houseofnorth/mpmother/media/Controller.png

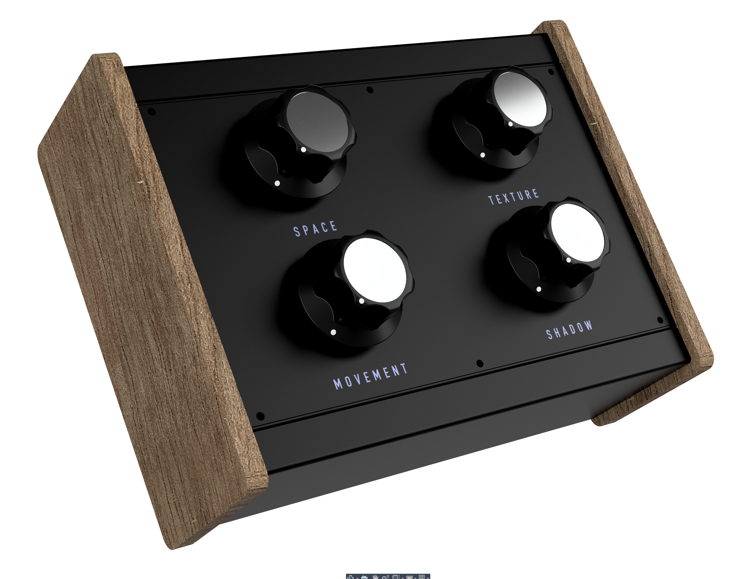
media/Controller.png
