houseofnorth/mpmother/(commit log)

2026-11-06 Import Teensy 3.2 Motorpot sketch
2026-11-06 Convert to PlatformIO project for Teensy 4.1
    Sketch moved unchanged to src/main.cpp; still uses the old 3.2 pin map.
2026-11-06 MPMOTHER v1 firmware and web config tool
    - Teensy 4.1 pin map, 2x DRV8833 at 20 kHz with sleep and fault handling
    - Dual-wiper pots with wear and broken-gang detection
    - Knob states: idle, follow, user, saver, fault
    - Separate drive channel for Ableton plus mapping feedback
    - Watchdog, move timeouts, safe boot, RGB status LED
    - SysEx protocol and WebMIDI config/monitor page in docs/
    [console.cpp, knobs.cpp, knobs.h, led.cpp, led.h, main.cpp, midi_io.cpp]
2026-11-06 Config tool: black DIN Condensed redesign, live plots, demo mode
    - Rolling 10 s plot per knob: position, motor target, hand-on band
    - Ports auto-detected by name; picker only appears if MPMOTHER is not found
    - Two-click confirm instead of browser pop-ups
    - Demo mode simulates a controller for trying the page without hardware
2026-11-06 Remove screensaver
    Firmware, config tool, protocol and docs. Settings block is now 32 bytes;
    EEPROM magic bumped so old settings reset to defaults.
    [console.cpp, knobs.cpp, knobs.h, led.cpp, led.h, main.cpp, midi_io.cpp, settings.cpp]
2026-11-06 Config tool: hardware-editor settings banks and maintenance section
    - Settings as parameter cells (drag, scroll, arrows, +/-), banks A MIDI, B Motor, C Mapping
    - Changed values marked until saved; save bar shows change count, revert
    - Maintenance table: calibrated range, motor direction, pot wear, fault per knob
    - Per-knob calibration (firmware + protocol: calibrate takes a knob index)
    [console.cpp, knobs.cpp, knobs.h, main.cpp, midi_io.cpp, midi_io.h]
2026-11-06 Config tool: drop Knobs heading, 70s modular panel touches
    Warm silkscreen white, pilot-lamp orange status lamps, panel screws in module
    corners, module numbers, engraved scale on the plots, rocker switches for on/off.
2026-11-06 Fix knob order to match the board; record verified pin map
    Board nets run CH1 = SHADOW ... CH4 = SPACE. pins.h now lists pins in panel
    order (SPACE, TEXTURE, MOVEMENT, SHADOW), so CC 20-23 and the config page
    names match the knobs. Pin map checked against the Fusion schematic.
    [pins.h]
2026-11-06 Fix hand detection and serial status after screensaver removal
    - knobs: entering and moving in USER stored a pot reading / `true` as the
    last-hand-move time, so USER ended after one tick. A hand no longer won
    reliably, and holding a knob ran up false "motor not moving" faults.
    - console: `status` lost the speed argument, so the printout read garbage.
    - Tidy indentation left over from the same change.
    - Firmware builds clean with PlatformIO (teensy@5.0.0).
    [console.cpp, knobs.cpp]
2026-11-06 Track VS Code extension recommendations
    - .vscode/extensions.json: PlatformIO's recommended-extensions file.
2026-11-06 Per-knob channels; always write ch before CC
    - Every knob has its own send ch + CC and moved-by ch + CC (moved-by ch 0 = off)
    - Settings block is now 38 bytes, per knob: out ch, out CC, drive ch, drive CC.
    EEPROM magic bumped, firmware 1.1
    - Config page: bank A keeps Feedback + DIN out; Mapping has CH and CC rows for
    "Sends" and "Moved by", knobs as rows on narrow screens
    - Plain numbers in setting cells, labels read "CH 1 · CC 20"
    - Page ignores a settings block it does not understand and says to update the firmware
    - Console: outch / drivech take a knob number; status prints "sends ch 1 cc 20"
    - README and PROTOCOL updated
2026-11-06 Config tool: 2x2 knob monitors on smaller screens
    - At 900 px and below the four monitors sit in a 2x2 grid like the front panel,
    still pinned to the top
    - Each monitor: name and mode left, value right, plot underneath
    - Extra top padding so the panel screws clear the text
2026-11-06 Config tool: 2x2 knob page, settings on their own subpage
    - Main page: the four knobs in a 2x2 grid like the front panel, filling the screen,
    at every size. Compact quarters on phones, no Move slider on short screens
    - Settings, Maintenance and Log moved to a subpage (#settings), Settings / Monitor
    button in the top bar. Same page underneath, so the MIDI connection stays up
    - Half A, Half B and Difference left the knob monitors; they are live columns in
    Maintenance, with their own labels on narrow screens
    - Monitors no longer pinned; sections on the subpage open by default
    - README describes the new layout
2026-11-06 Config tool: Rams-style type scale, no module numbers
    - Removed the "Module 90x" lines from the knob monitors
    - One type scale as tokens: caption 12, text 15, reading 20, name 28, value 46,
    display 84 (10 on small screens), one tracking per role instead of nine
    - All labels, heads, key, log and footer share the caption style
    - Disabled quiet buttons (Revert, Save) now look disabled
    - Plot scale numbers use the small caption size
2026-11-06 Config tool: vertical Move fader on the plot scale, handle = head of the line
    - The 0-127 scale next to each plot is now the Move fader; the horizontal slider is gone
    - Its handle is the head of the line: a flat cap on the scale that rides with the knob's value
    - Drag (or click) to move the knob on its moved-by CH + CC; the cap follows the finger and the
    line catches up, then the cap hands back to the knob's real position
    - Arrow keys step 1 (shift = 10); the fader is a proper slider for screen readers
    - Empty marker on the scale shows where the motor is heading
    - "Sends CH · CC" and "Moved by CH · CC" sit under each knob's value
2026-11-06 Industry-standard wording; warning above the mode
    - Status strip: Motors (Active / Standby), MIDI In, MIDI Out (Active / Idle), in before out
    - Knob modes: Idle, Moving, Touch, Fault. Key: Position, Target, Touch
    - Faults: Wiper mismatch, Motor reversed, Motor stalled; warning: Pot wear
    - Knob labels and Mapping use MIDI Out / MIDI In instead of Sends / Moved by
    - Maintenance: Cal range, Polarity, Wiper A, Wiper B, Mismatch
    - Write instead of Save, device instead of controller, DIN Out, MIDI input / output ports
    - Warning now sits above the mode, so every mode is on the bottom line of its quarter
    - Serial console, PROTOCOL and README use the same words
    [console.cpp, knobs.cpp, main.cpp]
2026-11-06 Config tool: title bar as one closed row
    - Removed the faint rule under the status row
    - Status row sits directly on the knob panel's top rule
    - Dividers between Motors, MIDI In, MIDI Out and Firmware are the same 1 px ink rule,
    running from the top rule to the panel rule
2026-11-06 Config tool: Demo moves the real knobs
    - With a device connected, Demo plays random moves on the real knobs by sending each
    knob's MIDI In CH + CC, a 2-5 s pause after each move, knobs staggered
    - Skips knobs that are touched, faulted, being dragged on their fader, or have MIDI In off
    - Demo button lights pilot-lamp orange while running; press again (or disconnect) to stop
    - Without a device, Demo still starts the simulated device; pressing it again stops that too
2026-11-06 Config tool: plain, professional settings page
    - General list: Feedback and DIN Out as slide switches, Speed as slider plus number field
    - MIDI mapping as a table, a row per knob: MIDI Out CH / CC and MIDI In CH / CC
    - Channels are dropdowns (MIDI In has Off), CC values are typed number fields;
    arrow keys step, shift = 10, out-of-range values clamp when leaving the field
    - Removed the big parameter cells, meters, rockers, panel screws, bank badges and drag-to-change
    - Changed values turn amber; Write / Revert bar stays at the bottom of the screen
2026-11-06 Config tool: installable app that works offline
    - Web app manifest, app icons (four knobs 2x2, cream on black, orange pointer; any + maskable)
    - sw.js keeps a copy for offline use: newest page when online, stored copy when offline
    - Barlow Condensed bundled in docs/fonts (SIL OFL) instead of loading from Google Fonts
    - Install button in the top bar, shown only when Chrome / Edge offers to install the page
    - Offline cache only registers on the published https site, so local previews are not cached
    - README: how to install
2026-11-07 Console: status prints once; first firmware on the Teensy
    - "status" printed its report twice (once for the command, once after every command)
2026-11-07 Knobs: tuning for slow, weak motors on 5 V
    - Calibration drives each way at full speed (255) until the pot stops changing
    (no more than 3 counts in 400 ms), with a 6 s safety timeout per direction.
    The direction check works the same way. Both end stops are then found with a
    full travel each, and the printout shows low, high, reverse and the travel time
    to each end (plus "timeout" or "driver fault" when that happened).
    - Stall check: the knob must gain STALL_PROGRESS (4 counts) within STALL_WINDOW_MS
    (600 ms) after a SPINUP_MS (300 ms) grace time. Touch vs dead motor logic unchanged.
    - MIN_DUTY renamed MIN_DRIVE and raised 70 -> 150: the lowest PWM a moving motor gets,
    including t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
    [knobs.cpp, knobs.h]
2026-11-07 Knobs: kick to start, small stalls near the target count as arrived
    - Slow automation (e.g. 20 BPM) sends one-step moves (~8 ADC counts). They ran at MIN_DRIVE,
    too weak to start the gearbox from standstill, and the stall check read that as a hand
    (Touch), then after three as Fault "motor stalled".
    - A move from standstill, or one that turns round, now starts with a kick: KICK_DRIVE (255)
    for up to KICK_MS (60 ms), ending as soon as the knob has moved KICK_MOVED (2) counts.
    Moves that just continue keep any kick still running.
    - Stuck within NEAR_STEPS (2) CC steps of the target counts as arrived: no Touch, no strike.
    [knobs.cpp]
2026-11-07 Remove pot wear
    - No wear warning in the firmware: no amber LED blink, no "wear" in the console status
    - Status flag bit 0 is now unused (the config page already ignored it)
    - Wiper mismatch fault stays (both gangs only); comments say mismatch instead of worn
    - README LED table and PROTOCOL updated
2026-11-07 Add hardware folder for schematics and board files
    - hardware/README.md: what goes there (schematics, board files, manufacturing output, BOM)
2026-11-07 Hardware: Gerbers for both boards
    - hardware/gerbers: Fusion manufacturing output for MPMOTHER v1 (main board) and MPCHILD v1 (pot board), as ordered
    - hardware/README.md: which zip is which board
2026-11-07 README: hardware section with the board pictures
    - hardware/README.md lists the schematic, board file and Gerbers, and shows the renders,
    layout and schematic from media/
    - README: short Hardware section with the main board and pot board renders
2026-11-07 Motors on/off setting, MIDI In moves send, hand detection during MIDI streams
    - Hand detection now works while MIDI In streams values (LFO, automation): a new value in
    the same direction continues the move instead of restarting its spin-up and stall timers
    - A knob moved by MIDI In sends its position on its MIDI Out, so a mapped parameter follows,
    and ends on exactly the value it was given. Mapping feedback moves still send nothing
    - Mapping feedback right after the knob sent is treated as Live's echo, whatever its value
    - Stall / push-back count towards a motor fault only if nothing moved after the motor let go,
    so grabbing a knob a few times no longer locks it as "motor reversed" for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
    [console.cpp, knobs.cpp, knobs.h, midi_io.cpp, motors.cpp, settings.cpp, settings.h]
2026-11-10 Config page: only connect to MPMOTHER, never silently to another MIDI port
    - No fallback to the first port when MPMOTHER is missing; show a not-found notice with a cable/hub checklist
    - Manual port choice moved behind an 'Other port…' link
    - Shown as Online only after the device answers hello; a port that stays silent for 1.5 s is dropped with a notice
    Claude-Session: https://claude.ai/code/session_01CNKX9HGS8Exn8haA2wSC4r
